andrewwong09/Self-Balancing-Cube/ESP32_HUZZAH_cube/pcb/sb_cube/sb_cube/sb_cube.kicad_pcb

## KiCad design ESP32_HUZZAH_cube/pcb/sb_cube/sb_cube/sb_cube.kicad_pcb (2026-03-16)

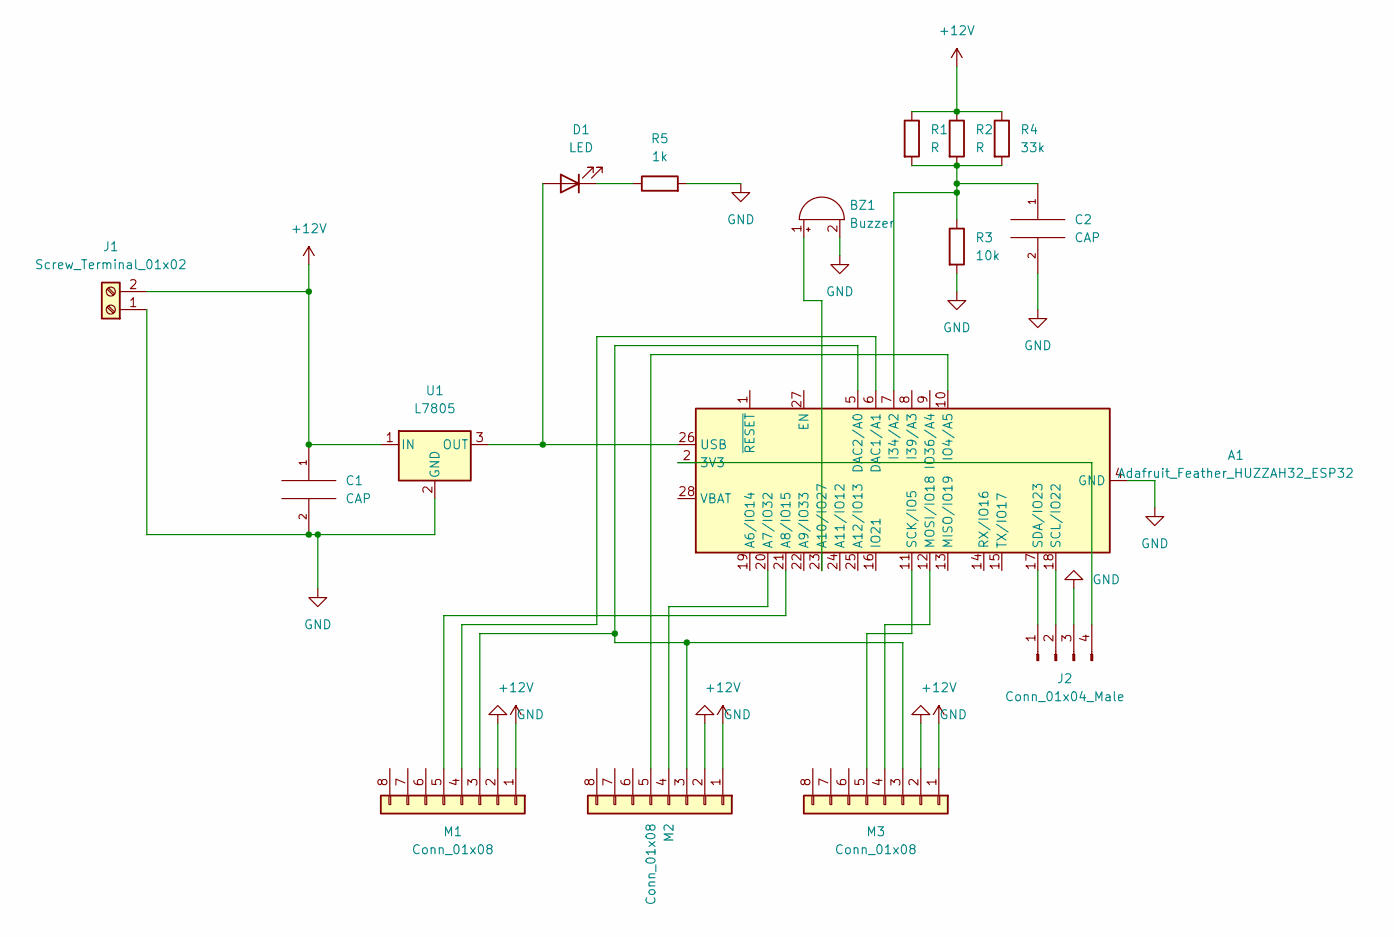
[picture p1: schematic sb_cube.kicad_sch]

Parts:
A1: Adafruit_Feather_HUZZAH32_ESP32; Adafruit_Feather
BZ1: Buzzer; Buzzer_12x9.5RM7.6
C1: CAP; CP_Radial_D10.0mm_P5.00mm
C2: CAP; C_Disc_D7.5mm_W2.5mm_P5.00mm
D1: LED; LED_D5.0mm
J1: Screw_Terminal_01x02; TerminalBlock_Altech_AK300-2_P5.00mm
J2: Conn_01x04_Male; PinSocket_1x04_P2.54mm_Vertical
M1, M2, M3: Conn_01x08; PinSocket_1x08_P2.54mm_Vertical
R1, R2: R; R_Axial_DIN0207_L6.3mm_D2.5mm_P7.62mm_Horizontal
R3: 10k; R_Axial_DIN0207_L6.3mm_D2.5mm_P7.62mm_Horizontal
R4: 33k; R_Axial_DIN0207_L6.3mm_D2.5mm_P7.62mm_Horizontal
R5: 1k; R_Axial_DIN0207_L6.3mm_D2.5mm_P7.62mm_Horizontal
U1: L7805; PinSocket_1x03_P2.54mm_Horizontal

Connections:
+12V: C1.1, J1.2, M1.1, M2.1, M3.1, R1.1, R2.1, R4.1, U1.1 (IN)
GND: A1.4 (GND), BZ1.2 (+), C1.2, C2.2, J1.1, J2.3, M1.2, M2.2, M3.2, R3.2, R5.2, U1.2 (GND)
unnamed: A1.2 (3V3), J2.4
unnamed: A1.7 (I34/A2), C2.1, R1.2, R2.2, R3.1, R4.2
unnamed: A1.12 (MOSI/IO18), M3.4
unnamed: A1.17 (SDA/IO23), J2.1
unnamed: A1.18 (SCL/IO22), J2.2
unnamed: A1.20 (A7/IO32), M2.4
unnamed: A1.21 (A8/IO15), M1.5
unnamed: A1.26 (USB), D1.2 (A), U1.3 (OUT)
unnamed: A1.23 (A10/IO27), BZ1.1 (-)
unnamed: D1.1 (K), R5.1
unnamed: A1.6 (DAC1/A1), M1.4
unnamed: A1.10 (IO4/A5), M2.5
unnamed: A1.5 (DAC2/A0), M1.3, M2.3, M3.3
unnamed: A1.11 (SCK/IO5), M3.5

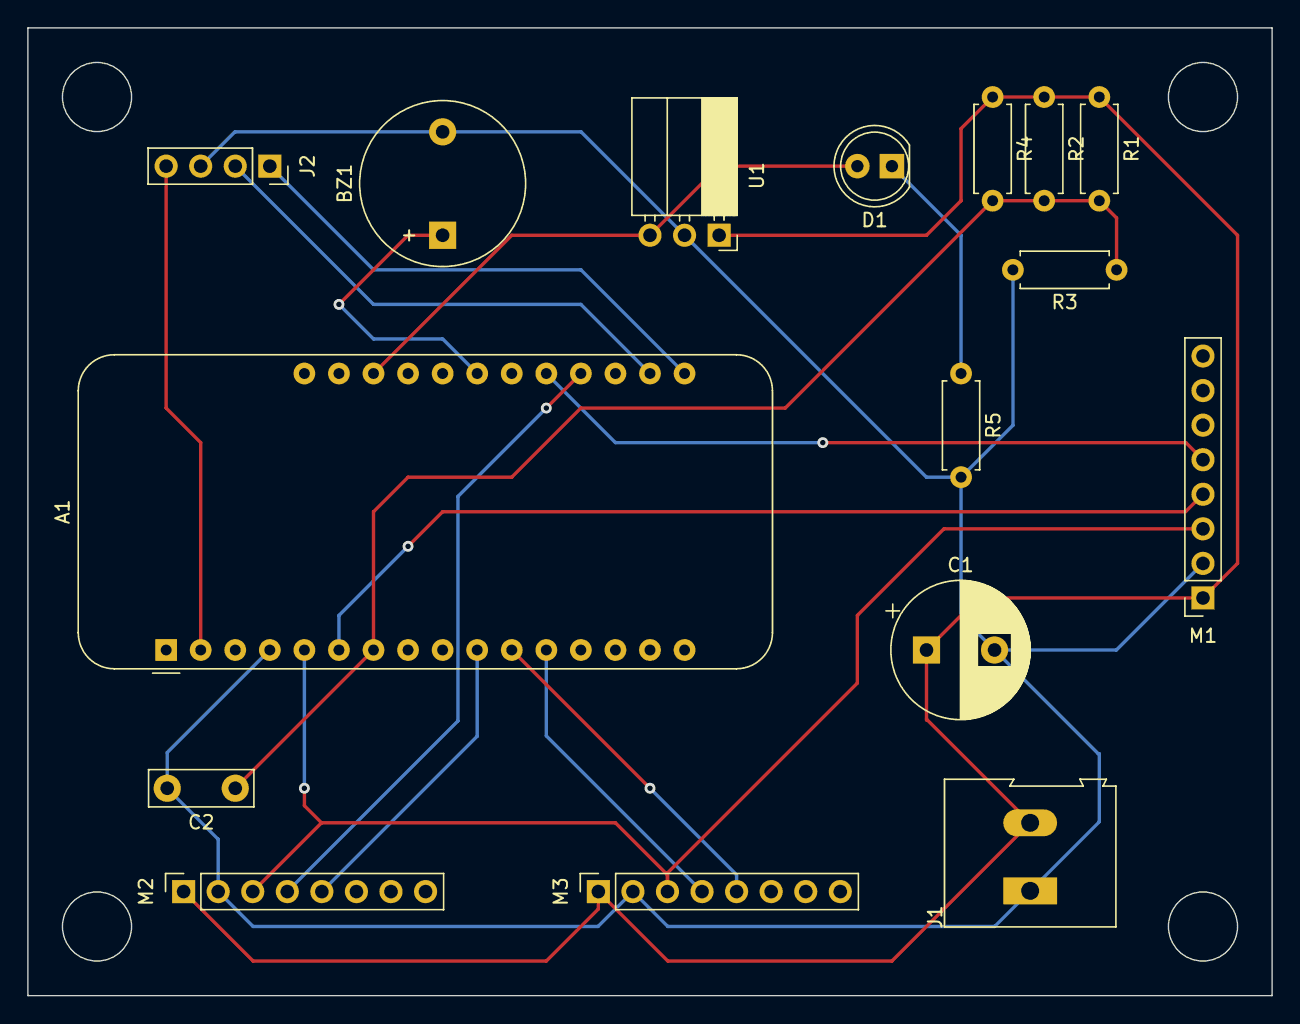
[picture p2: board sb_cube.kicad_pcb from above]

Board: 2 copper layers, 91.4 x 71.1 mm, 16 parts (0 on the bottom side), 16 nets.
