andrewwong09/Self-Balancing-Cube/(commit log)

2024-03-19 Added README and copied files for development of ESP32 HUZZAH feather device.
2026-03-14 reoganized arduino code into separate directories. motors_test tests buzzer and does serial prints
    [ESP32.h, ESP32_cube.ino, functions.ino, motors_test.ino]
2026-03-14 updated README about esp32 library version
2026-03-14 Voltage reading added.
2026-03-14 Fix bug; No extra true in requestFrom, no extra Wire.beginTransmission in the middle.
    [functions.ino]
2026-03-15 v1 pcb
    [sb_cube.kicad_pcb, sb_cube.kicad_sch]
2026-03-16 active to passive buzzer changes
    [ESP32.h, ESP32_cube.ino, functions.ino]
2026-03-16 V2 to pcbway
    [sb_cube.kicad_pcb]
2026-03-16 updated voltage reader
